xdylanm/sample-and-hold/README.md

# Sample and Hold

A sample and hold circuit for a modular synth (Eurorack format) based on the LF398.
