xdylanm/sample-and-hold/docs/assets/schematic.pdf

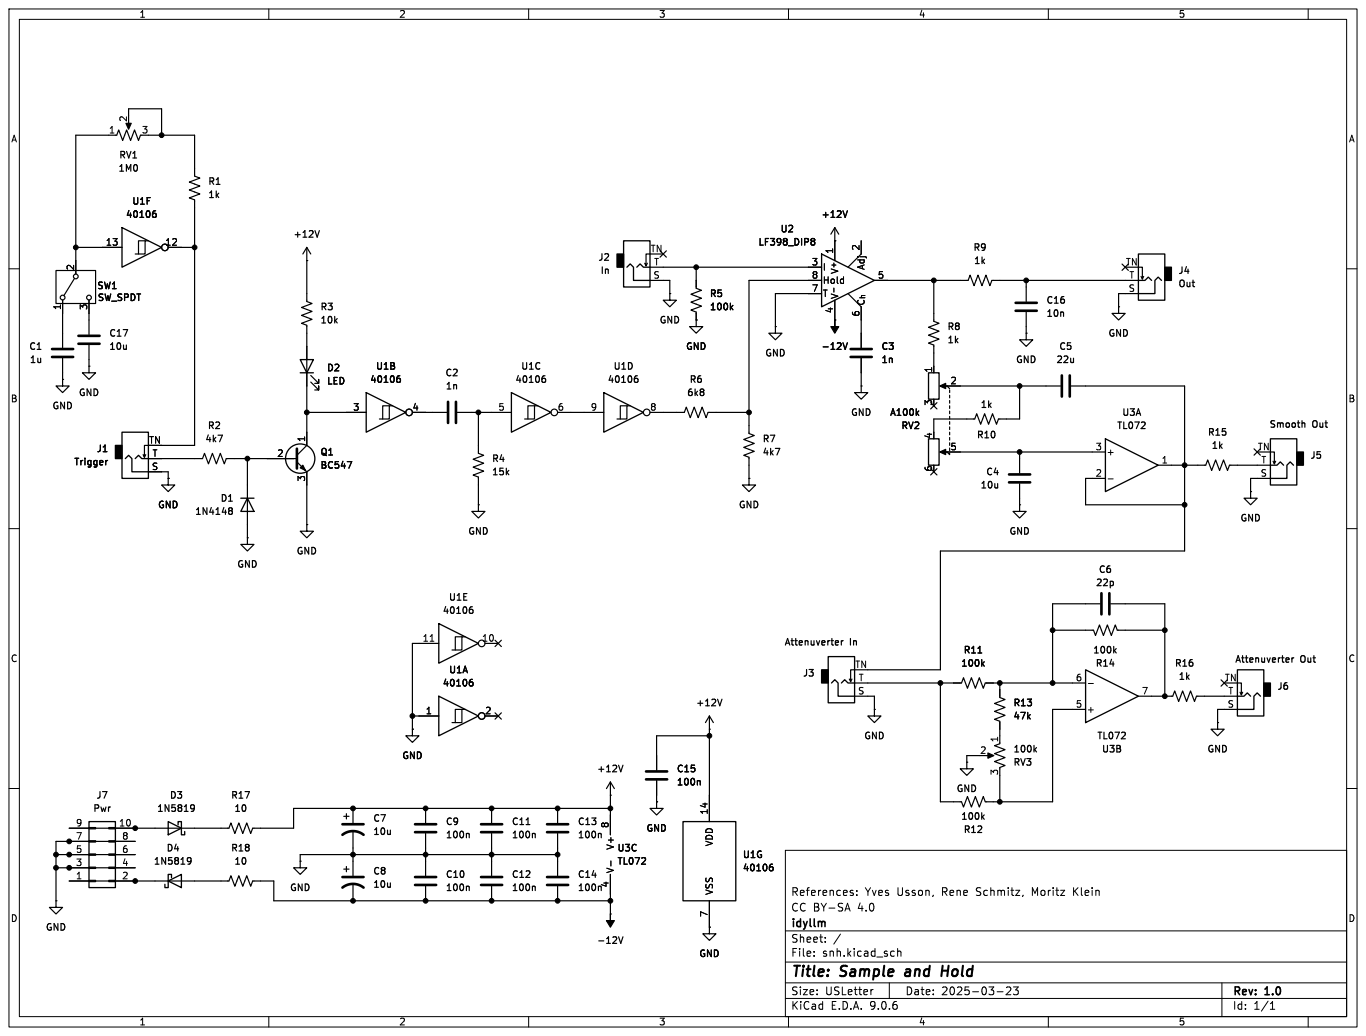
[picture p1: page 1]

idyllm
File: snh.kicad_sch Sheet: /
Id: 1/1 Title: Sample and Hold
