xdylanm/sample-and-hold/hardware/snh/snh.kicad_pcb

## KiCad design hardware/snh/snh.kicad_pcb (2025-12-28)

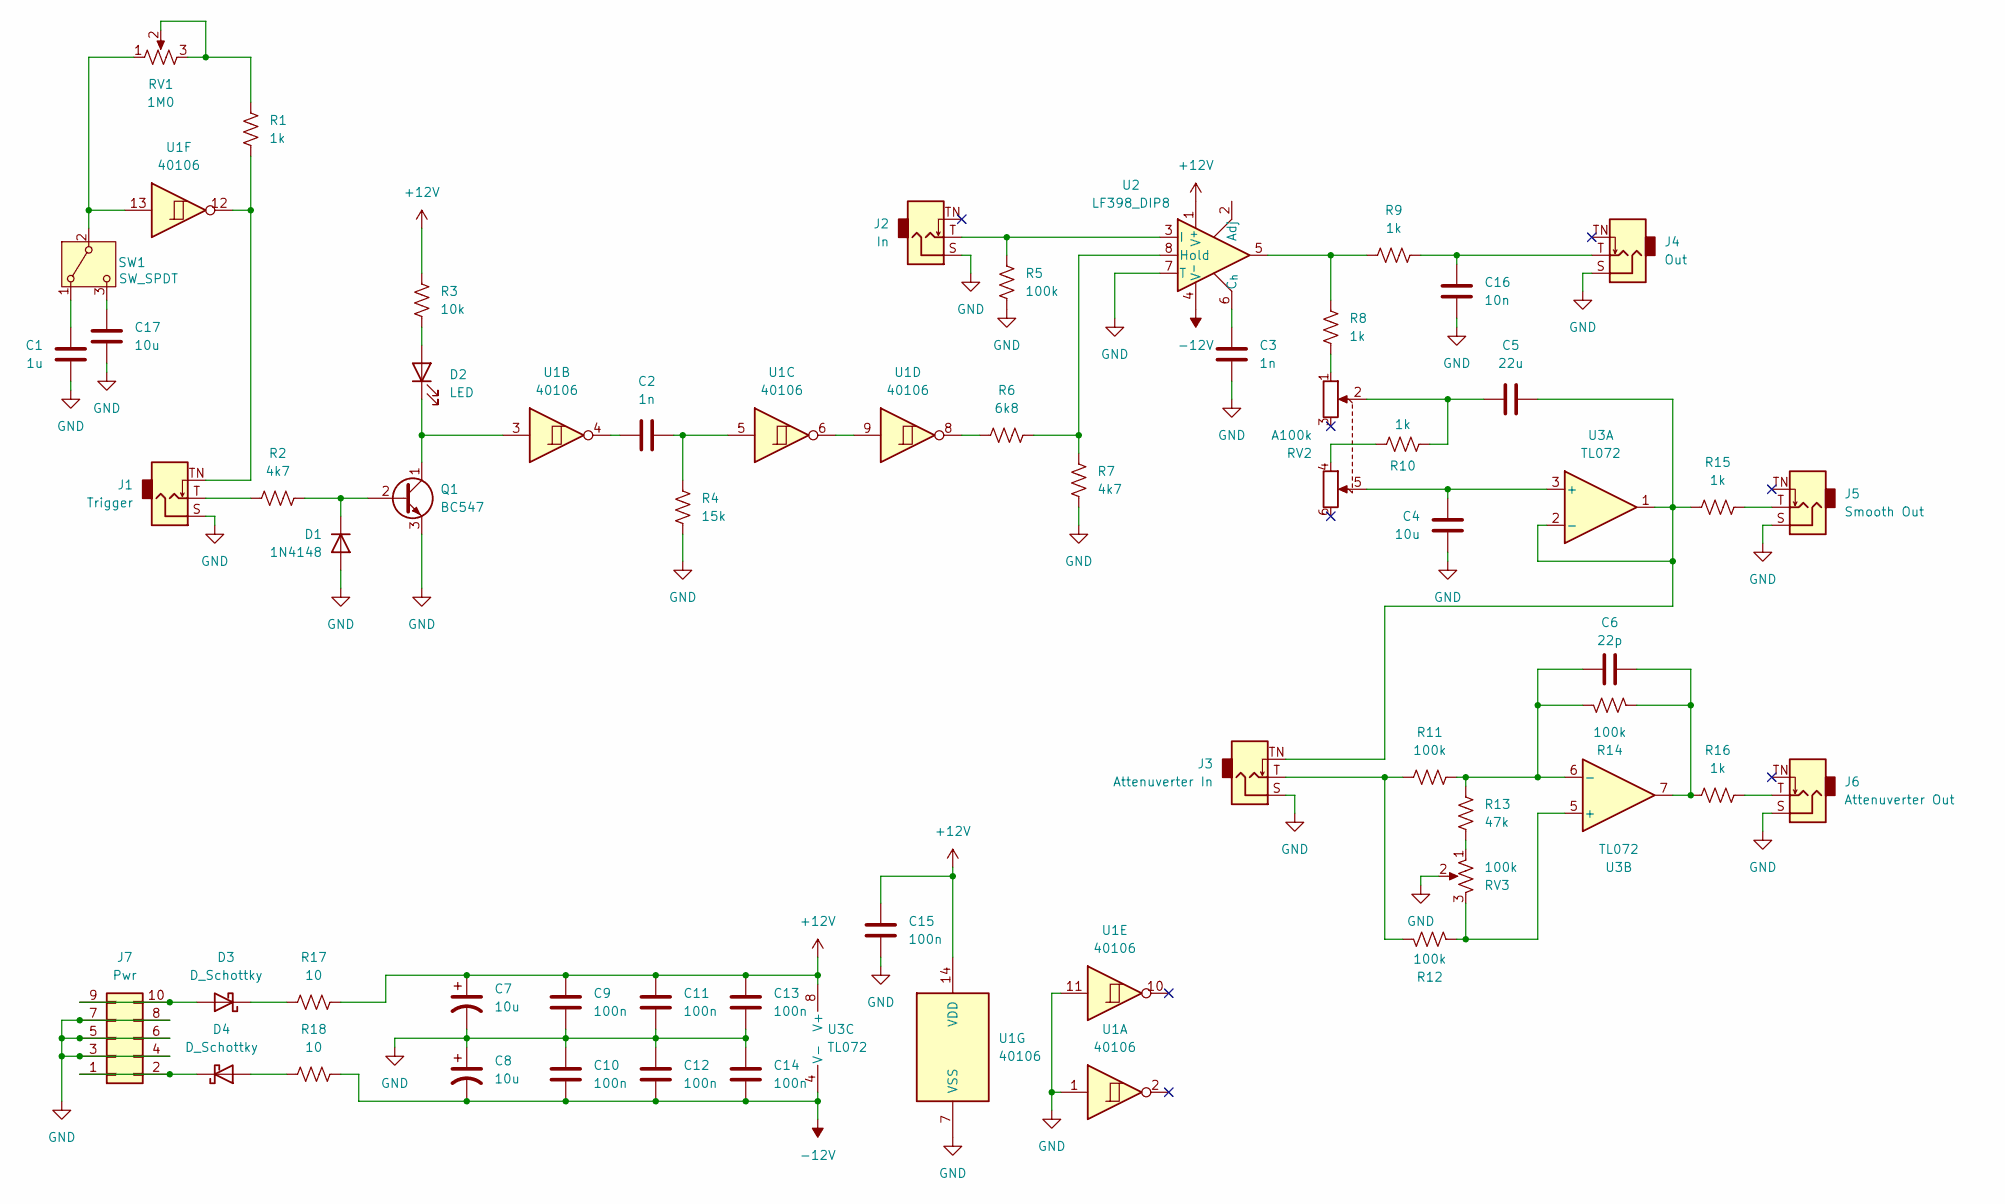
[picture p2: schematic snh.kicad_sch, Sample and Hold]

Parts:
C1: 1u; C_Disc_D4.7mm_W2.5mm_P5.00mm
C2: 1n; C_Disc_D5.0mm_W2.5mm_P5.00mm
C3: 1n; C_Rect_L7.0mm_W2.0mm_P5.00mm
C4, C17: 10u; C_Disc_D4.7mm_W2.5mm_P5.00mm
C5: 22u; C_Disc_D4.7mm_W2.5mm_P5.00mm
C6: 22p; C_Disc_D4.7mm_W2.5mm_P5.00mm
C7, C8: 10u; CP_Radial_D4.0mm_P2.00mm
C9, C10, C11, C12, C13, C14, C15: 100n; C_Disc_D4.7mm_W2.5mm_P5.00mm
C16: 10n; C_Disc_D4.7mm_W2.5mm_P5.00mm
D1: 1N4148; D_DO-35_SOD27_P2.54mm_Vertical_AnodeUp
D2: LED; LED_D3.0mm_Clear
D3, D4: D_Schottky; D_DO-35_SOD27_P2.54mm_Vertical_AnodeUp
J1: Trigger; Jack_3.5mm_QingPu_WQP-PJ301M-12_Vertical
J2: In; Jack_3.5mm_QingPu_WQP-PJ301M-12_Vertical
J3: Attenuverter In; Jack_3.5mm_QingPu_WQP-PJ301M-12_Vertical
J4: Out; Jack_3.5mm_QingPu_WQP-PJ301M-12_Vertical
J5: Smooth Out; Jack_3.5mm_QingPu_WQP-PJ301M-12_Vertical
J6: Attenuverter Out; Jack_3.5mm_QingPu_WQP-PJ301M-12_Vertical
J7: Pwr; IDC-Header_2x05_P2.54mm_Vertical
Q1: BC547; TO-92_Inline_Wide
R1, R8, R9, R10, R15, R16: 1k; R_Axial_DIN0204_L3.6mm_D1.6mm_P2.54mm_Vertical
R2: 4k7; R_Axial_DIN0204_L3.6mm_D1.6mm_P7.62mm_Horizontal
R3: 10k; R_Axial_DIN0204_L3.6mm_D1.6mm_P2.54mm_Vertical
R4: 15k; R_Axial_DIN0204_L3.6mm_D1.6mm_P2.54mm_Vertical
R5, R11, R12, R14: 100k; R_Axial_DIN0204_L3.6mm_D1.6mm_P2.54mm_Vertical
R6: 6k8; R_Axial_DIN0204_L3.6mm_D1.6mm_P2.54mm_Vertical
R7: 4k7; R_Axial_DIN0204_L3.6mm_D1.6mm_P2.54mm_Vertical
R13: 47k; R_Axial_DIN0204_L3.6mm_D1.6mm_P2.54mm_Vertical
R17, R18: 10; R_Axial_DIN0207_L6.3mm_D2.5mm_P10.16mm_Horizontal
RV1: 1M0; Potentiometer_Bourns_PTV09A-1_Single_Vertical
RV2: A100k; Potentiometer_Bourns_PTV112-4_Dual_Vertical
RV3: 100k; Potentiometer_Bourns_PTV09A-1_Single_Vertical
SW1: SW_SPDT; SW_Dailywell_SPDT_2MS1T1B1M1
U1: 40106; DIP-14_W7.62mm_Socket
U2: LF398_DIP8; DIP-8_W7.62mm_Socket
U3: TL072; DIP-8_W7.62mm_Socket

Connections:
+12V: C7.1, C9.1, C11.1, C13.1, C15.1, R3.1, R17.2, U1.14 (VDD), U2.1 (V^{+}), U3.8 (V+)
-12V: C8.2, C10.2, C12.2, C14.2, R18.2, U2.4 (V^{-}), U3.4 (V-)
GND: C1.1, C3.2, C4.1, C7.2, C8.1, C9.2, C10.1, C11.2, C12.1, C13.2, C14.1, C15.2, C16.2, C17.1, D1.2 (A), J1.S, J2.S, J3.S, J4.S, J5.S, J6.S, J7.3, J7.4, J7.5, J7.6, J7.7, J7.8, Q1.3 (E), R4.1, R5.1, R7.2, RV3.2, U1.1, U1.7 (VSS), U1.11, U2.7 (T)
unnamed: C2.1, U1.4
unnamed: C2.2, R4.2, U1.5
unnamed: C5.2, R10.2, RV2.2
unnamed: C6.2, R14.1, R16.2, U3.7
unnamed: C16.1, J4.T, R9.1
unnamed: D1.1 (K), Q1.2 (B), R2.1
unnamed: D2.2 (A), R3.2
unnamed: D2.1 (K), Q1.1 (C), U1.3
unnamed: D3.2 (A), J7.9, J7.10
unnamed: D3.1 (K), R17.1
unnamed: D4.2 (A), R18.1
unnamed: D4.1 (K), J7.1, J7.2
unnamed: J1.T, R2.2
unnamed: J1.TN, R1.1, U1.12
unnamed: J3.T, R11.2, R12.2
unnamed: J5.T, R15.1
unnamed: J6.T, R16.1
unnamed: R1.2, RV1.2, RV1.3
unnamed: R6.2, U1.8
unnamed: R8.1, R9.2, U2.5
unnamed: R8.2, RV2.1
unnamed: R10.1, RV2.4
unnamed: R13.2, RV3.1
unnamed: C1.2, SW1.1 (A)
unnamed: RV1.1, SW1.2 (B), U1.13
unnamed: C17.2, SW1.3 (C)
unnamed: U1.6, U1.9
unnamed: C3.1, U2.6 (C_{h})
unnamed: R6.1, R7.1, U2.8 (Hold)
unnamed: J2.T, R5.2, U2.3 (I)
unnamed: C4.2, RV2.5, U3.3 (+)
unnamed: C5.1, J3.TN, R15.2, U3.1, U3.2 (-)
unnamed: R12.1, RV3.3, U3.5 (+)
unnamed: C6.1, R11.1, R13.1, R14.2, U3.6 (-)

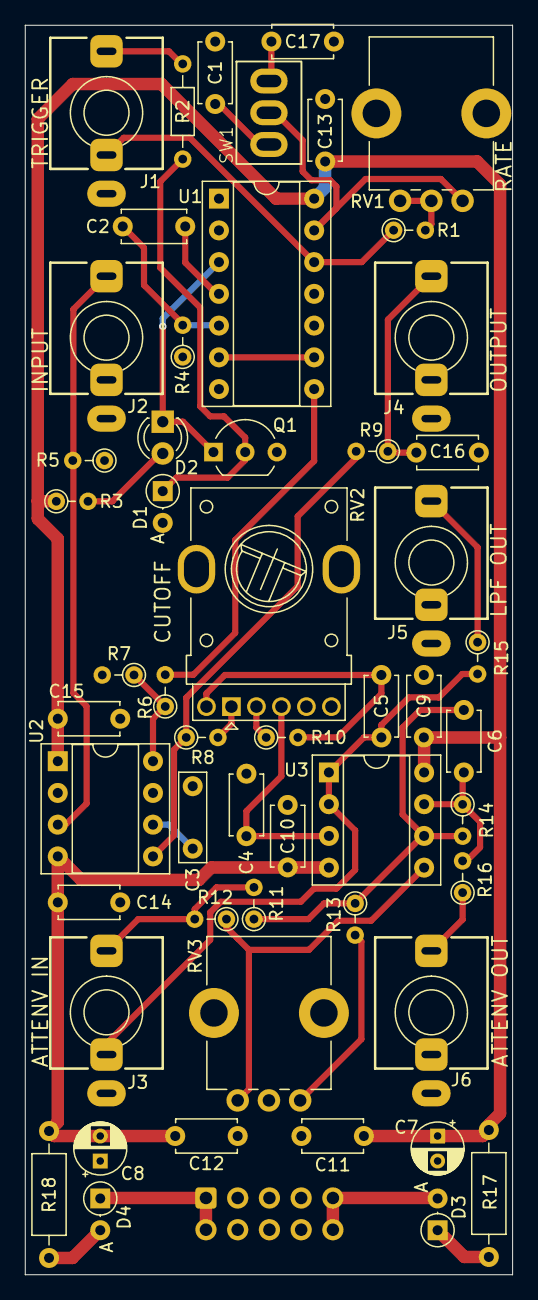
[picture p3: board snh.kicad_pcb from above]

Board: 2 copper layers, 39.0 x 100.0 mm, 54 parts (1 on the bottom side), 37 nets.
