xdylanm/sample-and-hold/(commit log)

2025-12-28 v1 board, no docs
    [snh.kicad_pcb, snh.kicad_sch, snh_faceplate.kicad_pcb, snh_faceplate.kicad_sch]
2025-12-28 Updating to mkdocs+material, generated BOM and schematic (small tweaks to clean up)
    [bom.csv, snh.kicad_sch]
