xdylanm/sample-and-hold/(notices)

Notices in the files:
hardware/snh_faceplate/snh_faceplate.kicad_sch:
CC BY-SA 4.0
